ikatkov/lc-meter/enclosure2.png

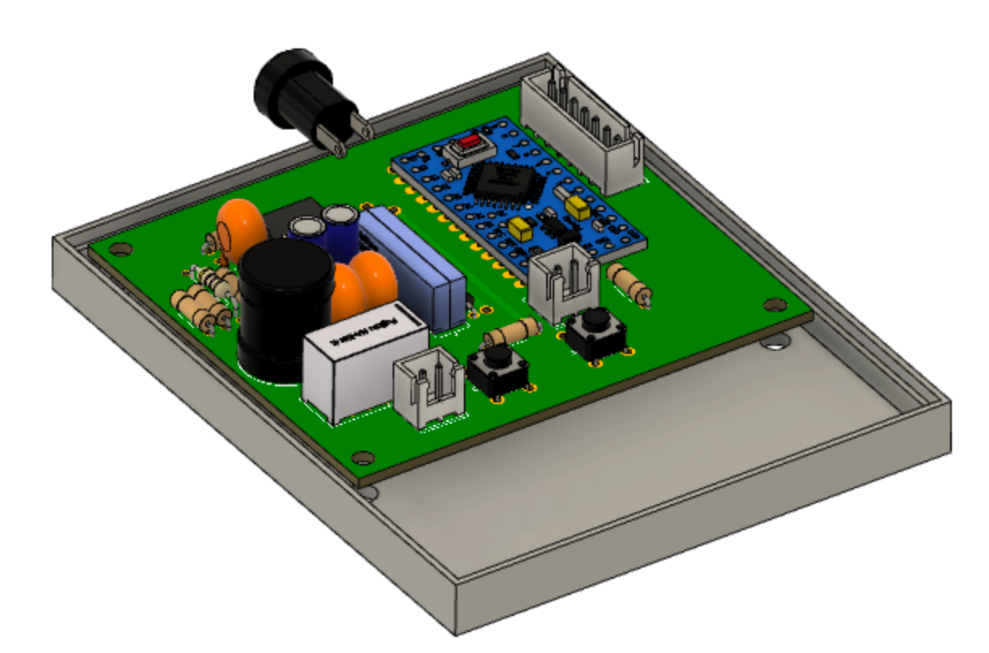
enclosure2.png
