ikatkov/lc-meter/README.md

# lc-meter
AADE design LC meter

arduino internal xtal is callibrated to 2ppm with Rigol DS1054Z hardware freq counter, used to be 500ppm off
