ikatkov/lc-meter/enclosure1.png

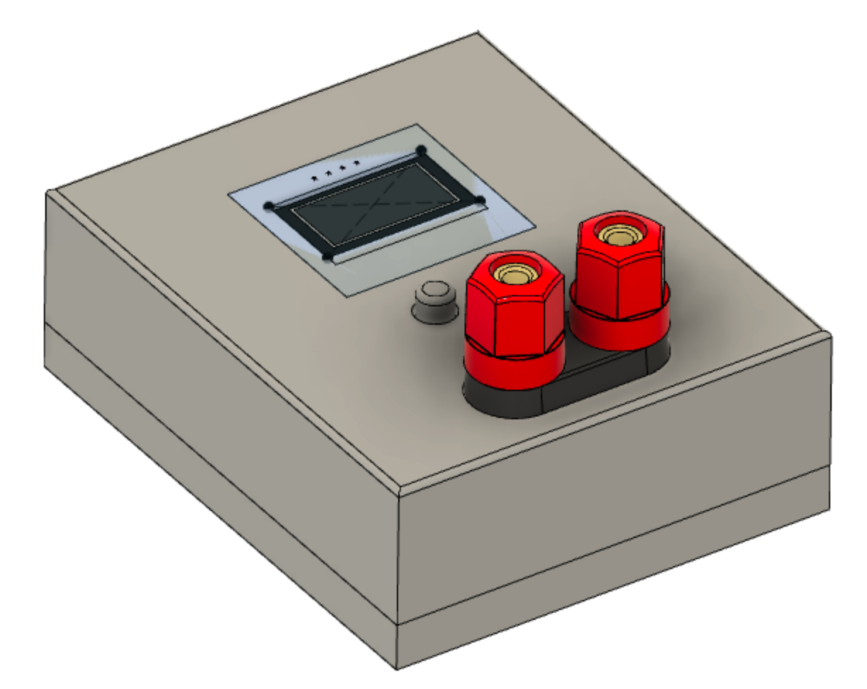
enclosure1.png
