ikatkov/lc-meter/pcb.png

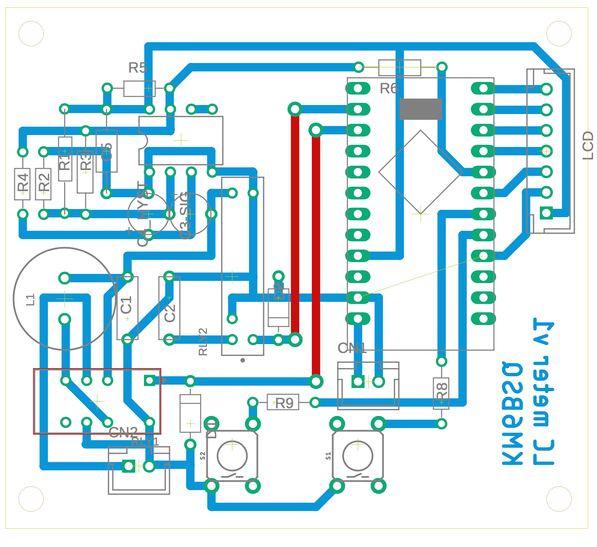
pcb.png
