ikatkov/lc-meter/schematic.png

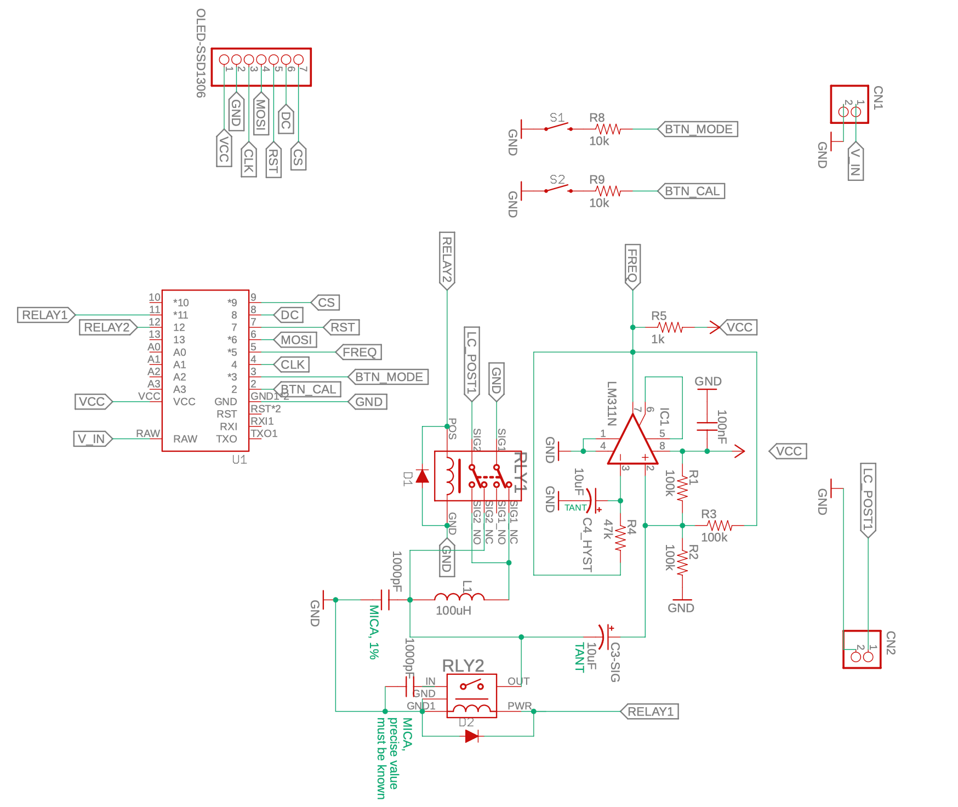
schematic.png
