ikatkov/lc-meter/LCM-schematic.pdf

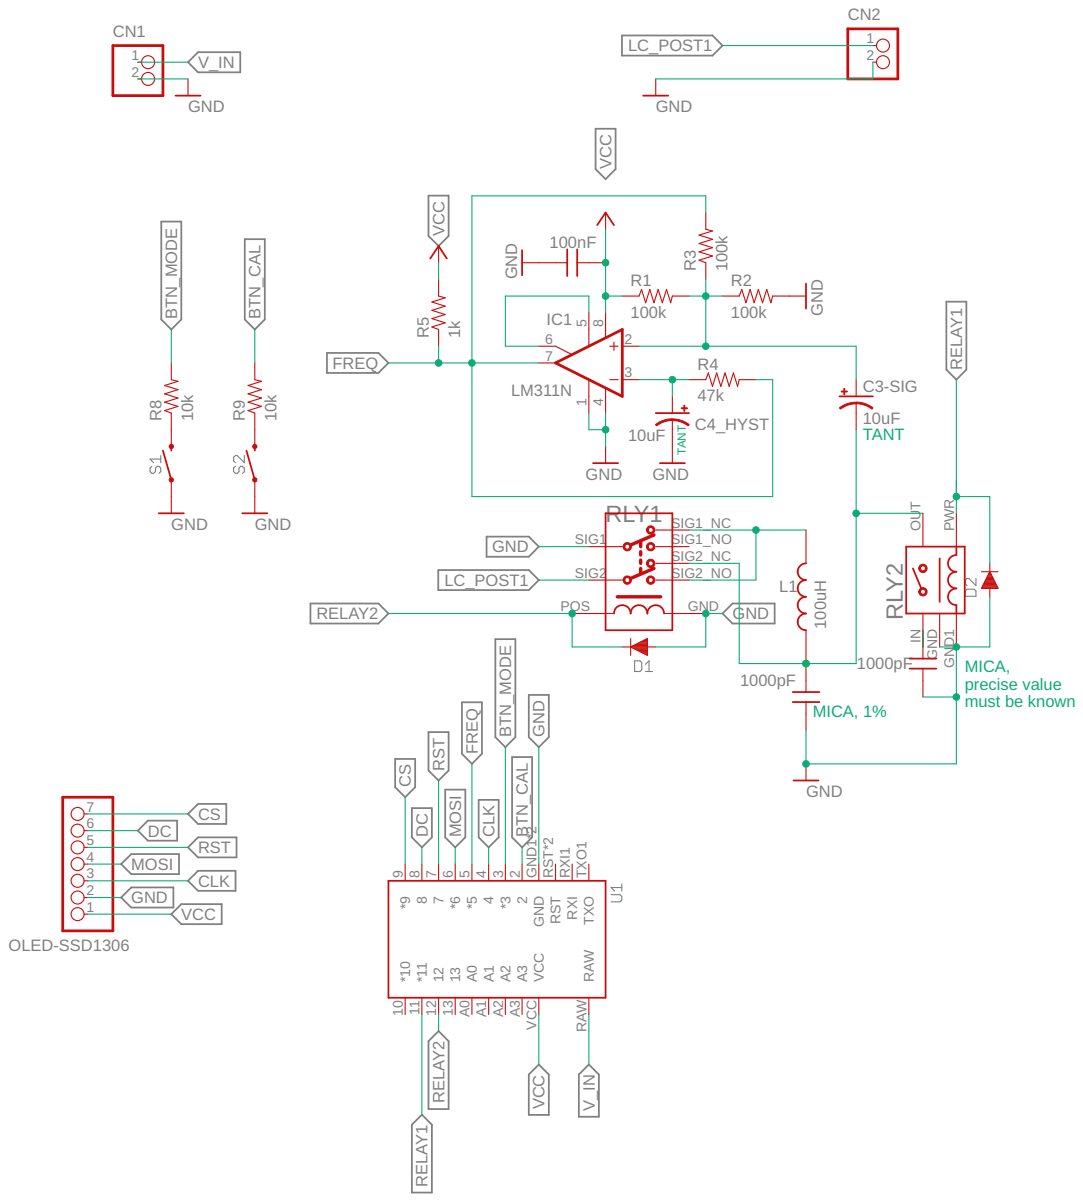
[picture p7: page 1]
