ikatkov/lc-meter/LCM-pcb.pdf

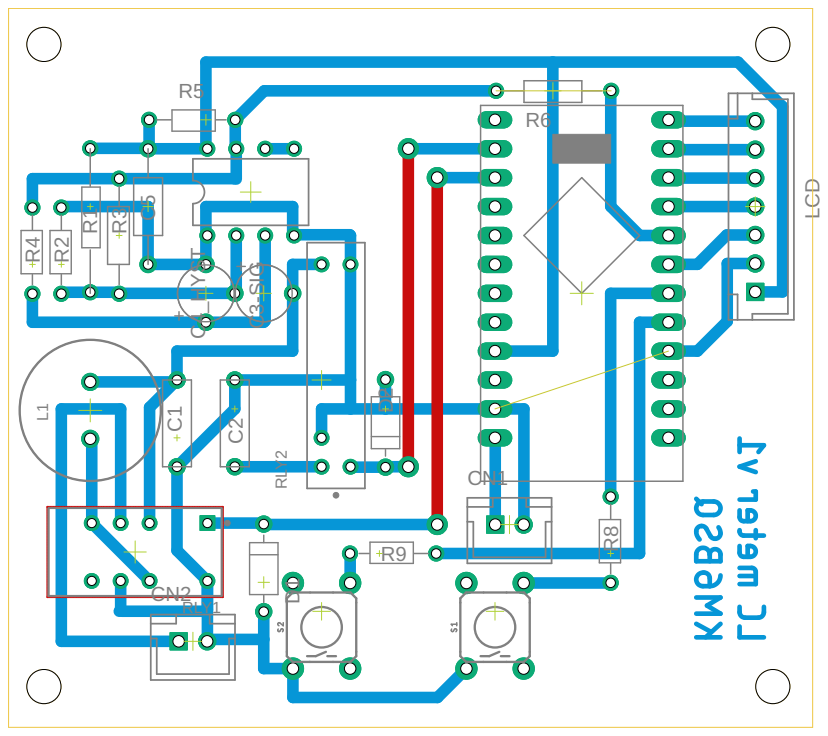
[picture p8: page 1]
