ikatkov/lc-meter/eagle-files/LCM.brd

## EAGLE design eagle-files/LCM.brd (2021-11-09)

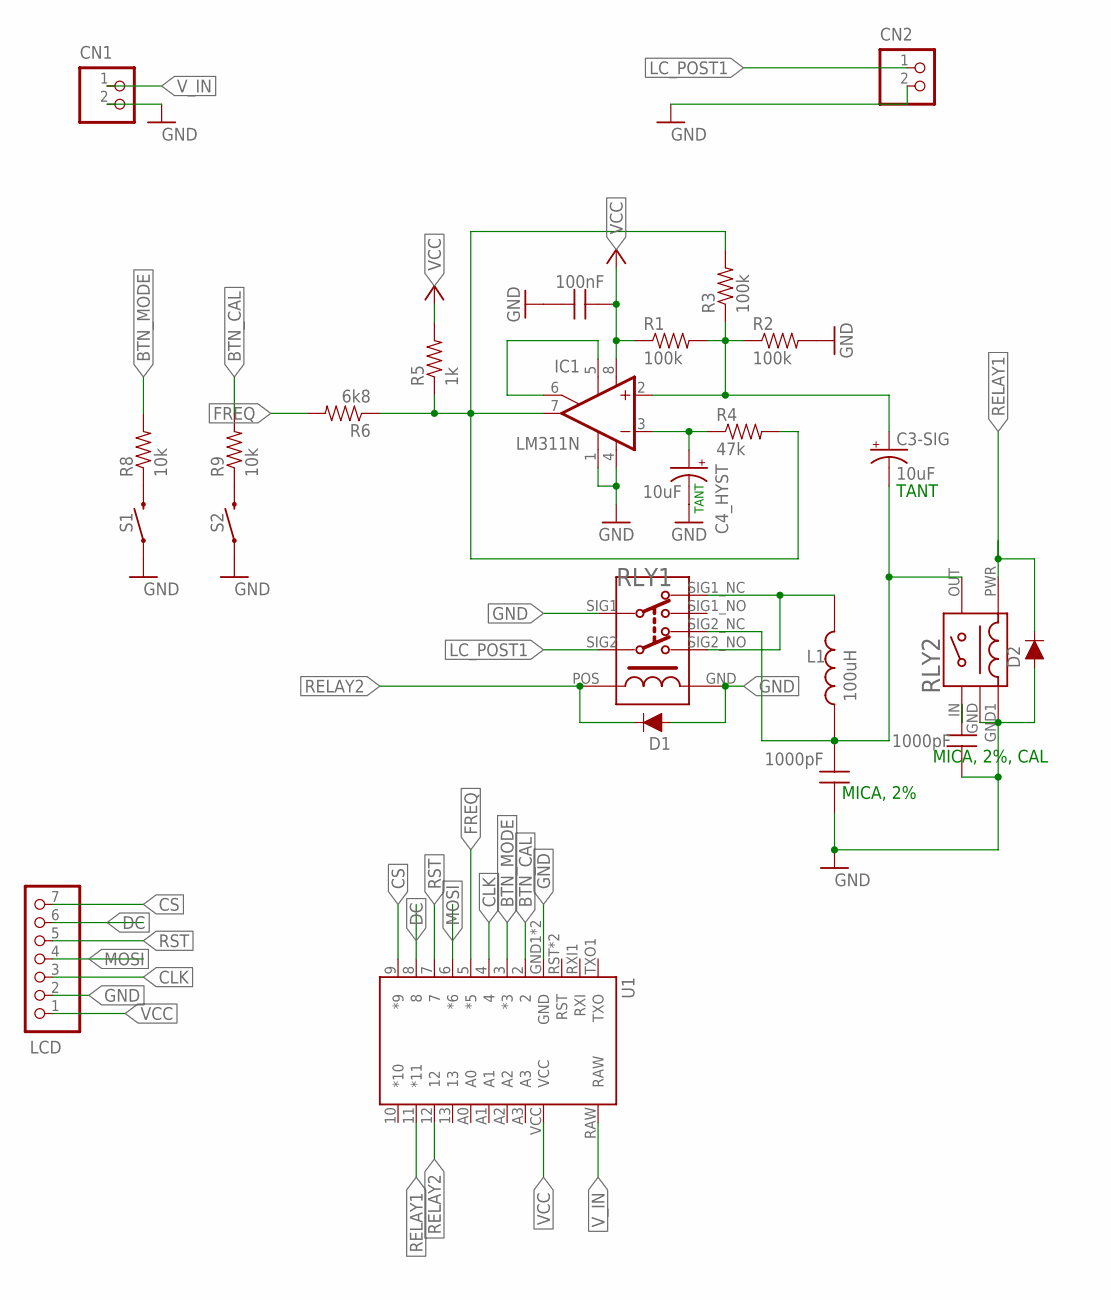
[picture p9: schematic LCM.sch]

Parts:
C1, C2: 1000pF; CAPACITOR_PITCH3
C3-SIG, C4_HYST: 10uF; CAPACITOR_POLAR
C5: 100nF; CAPACITOR_PITCH4
CN1, CN2: CONNECTOR-JST-2
D1, D2: DIODEPITCH_3; DIODE_PITCH3
IC1: LM311N; DIL08
L1: 100uH; INDUCTOR-12.5MM
LCD: CONNECTOR-JST-7
R1: 100k; RESISTOR_PITCH5
R2: 100k; RESISTOR_PITCH3
R3: 100k; RESISTOR_PITCH4
R4: 47k; RESISTOR_PITCH3
R5: 1k; RESISTOR_PITCH3
R6: 6k8; RESISTOR_PITCH4
R8, R9: 10k; RESISTOR_PITCH3
RLY1: RELAY_5W-KRELAY-5W-K; RELAY_5W-K
RLY2: REED_RELAY
S1, S2: MOMENTARY-SWITCH-SPST; TACTILE_SWITCH
U1: ARDUINO_PRO_MINI_NO_PRG_HEADER_NOA5NO_A5; ARDUINO_PRO_MINI_IN_HEADER_NOA5

Connections:
BTN_CAL: R9.2, U1.2
BTN_MODE: R8.2, U1.3 (*3)
CLK: LCD.3, U1.4
CS: LCD.7, U1.9 (*9)
DC: LCD.6, U1.8
FREQ: IC1.7 (OUT), R3.2, R4.2, R5.1, R6.1, R6.2, U1.5 (*5)
GND: C1.1 (+), C2.1 (+), C4_HYST.2 (-), C5.1 (+), CN1.2, CN2.2, D1.ANODE (A), D2.ANODE (A), IC1.1 (GND), IC1.4 (V-), LCD.2, R2.2, RLY1.GND (2), RLY1.SIG1, RLY2.GND, RLY2.GND1 (PWR1), S1.1, S1.2 (1), S2.1, S2.2 (1), U1.GND1 (GND), U1.GND4 (GND)
LC_POST1: CN2.1, RLY1.SIG2
MOSI: LCD.4, U1.6 (*6)
unnamed: R8.1, S1.3 (2), S1.4 (2)
unnamed: R9.1, S2.3 (2), S2.4 (2)
PIN2: C3-SIG.1 (+), IC1.2 (+IN), R1.2, R2.1, R3.1
PIN3: C4_HYST.1 (+), IC1.3 (-IN), R4.1
RELAY1: D2.CATHODE (C), RLY2.PWR (PWR2), U1.11 (*11)
RELAY2: D1.CATHODE (C), RLY1.POS (1), U1.12
RST: LCD.5, U1.7
SIG: C2.2 (-), RLY2.IN (SIG1)
SIG2_NC: C1.2 (-), C3-SIG.2 (-), L1.2, RLY1.SIG2_NC (SIG1_NC), RLY2.OUT (SIG2)
SIG2_NO: L1.1, RLY1.SIG1_NC (SIG2_NC), RLY1.SIG2_NO (SIG1_NO)
STROBE: IC1.5 (ON), IC1.6 (ON/STR)
VCC: C5.2 (-), IC1.8 (V+), LCD.1, R1.1, R5.2, U1.VCC
V_IN: CN1.1, U1.RAW

Notes on the sheet:
MICA, 2%
TANT
MICA, 2%, CAL

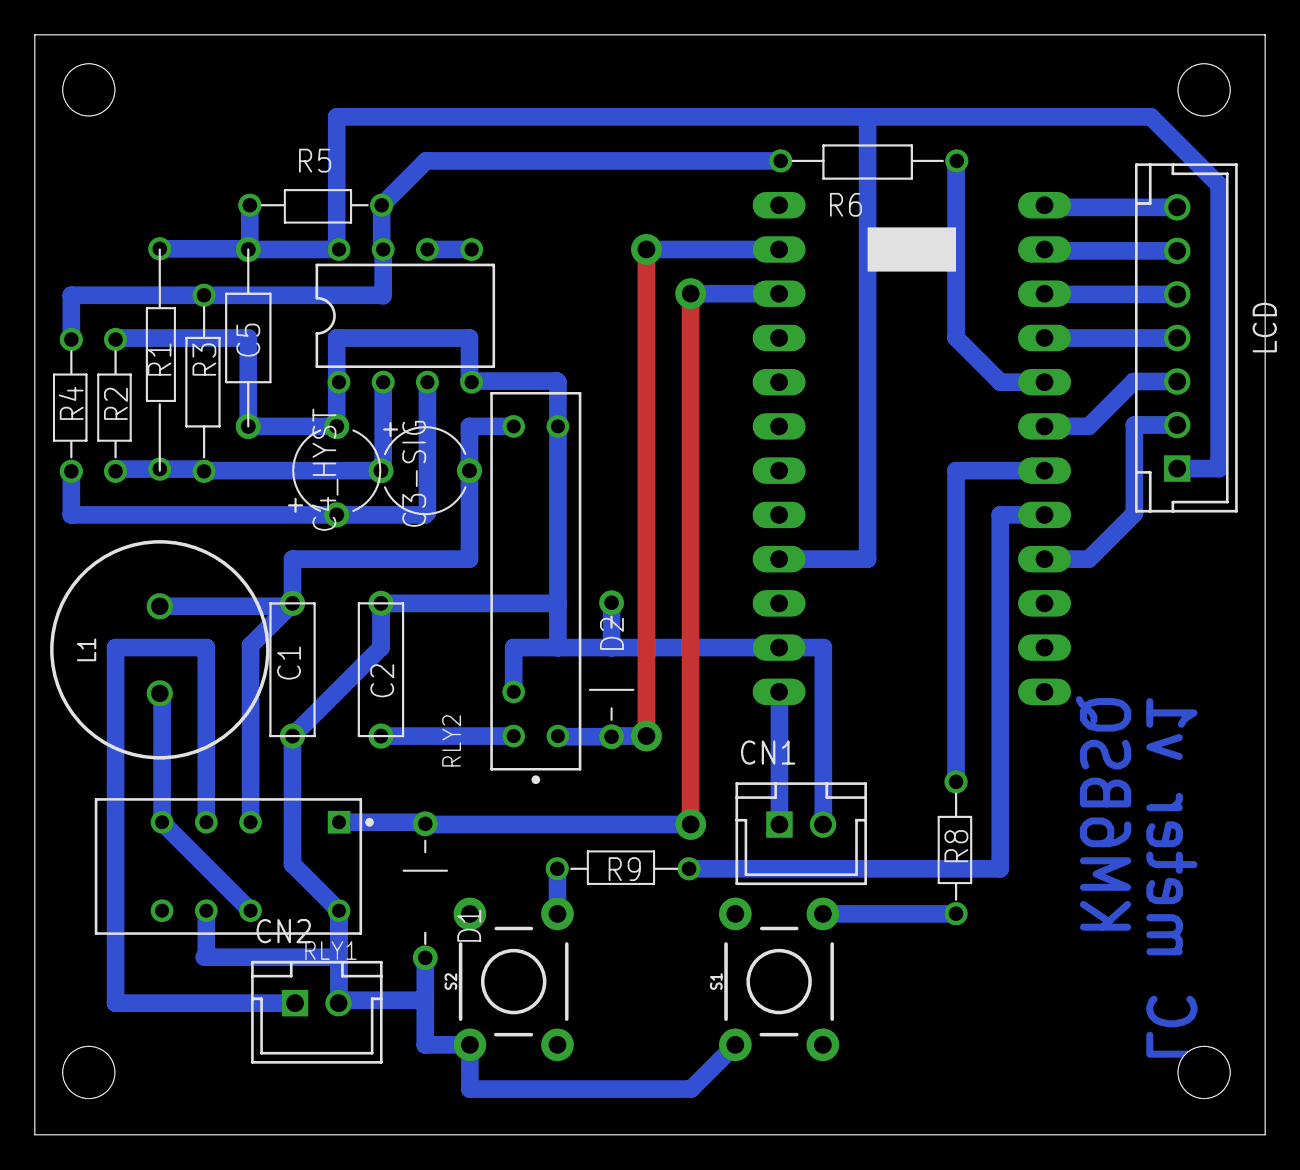
[picture p10: board LCM.brd from above]

Board: 2 copper layers, 70.6 x 63.2 mm, 25 parts (0 on the bottom side), 22 nets.
