ikatkov/lc-meter/(commit log)

2021-11-09 enclosure for 3d printing
2021-11-10 L calibration fix
